beauahill/SmartHub/docs/diagrams/2_base_and_spine.png

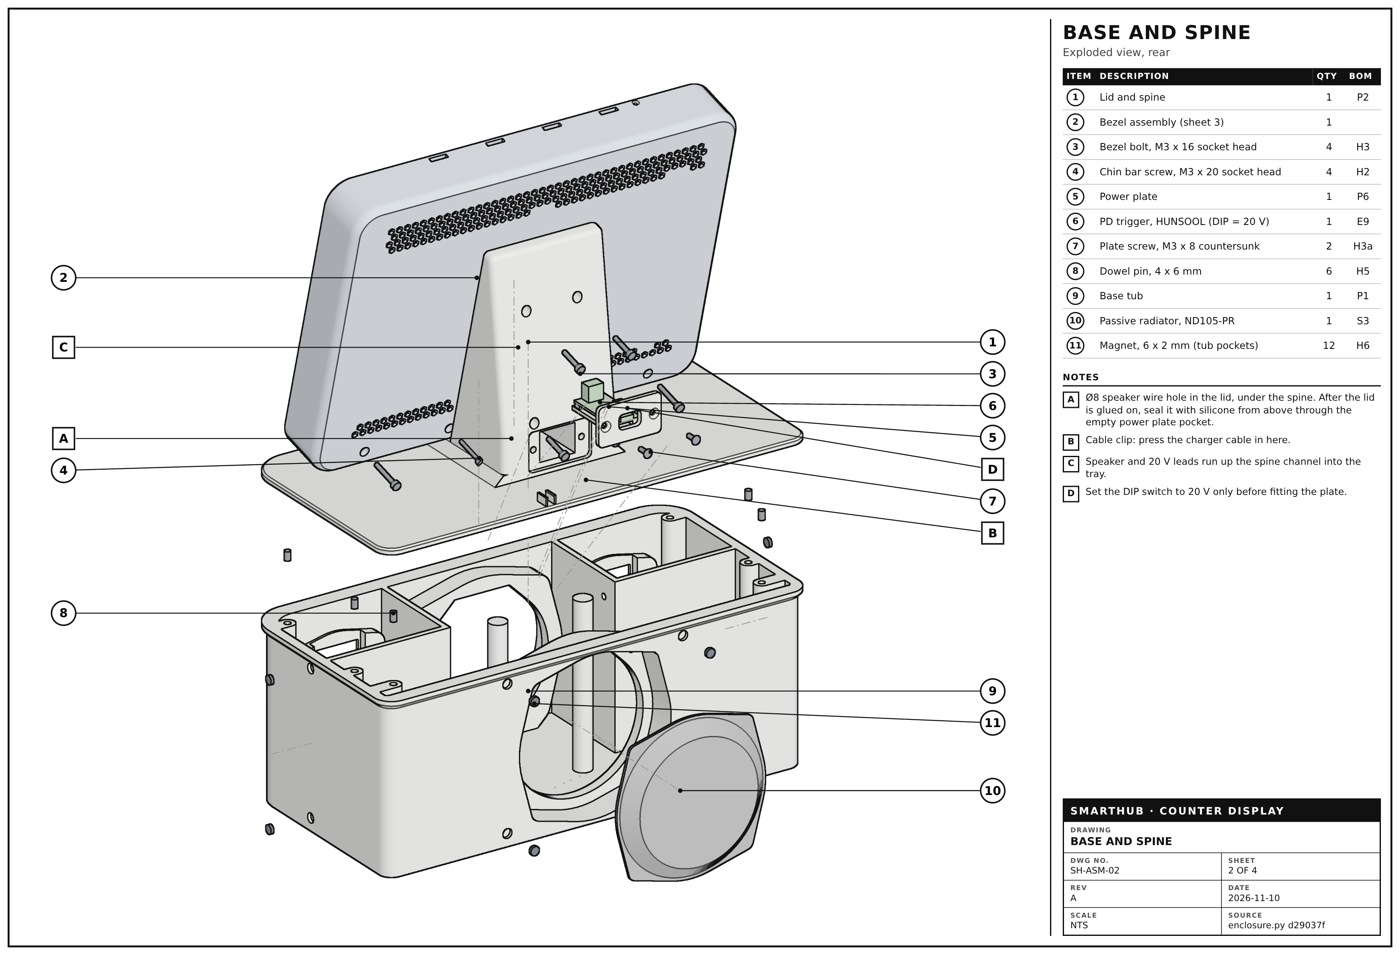
docs/diagrams/2_base_and_spine.png
