beauahill/SmartHub/enclosure/renders/current_corner.png

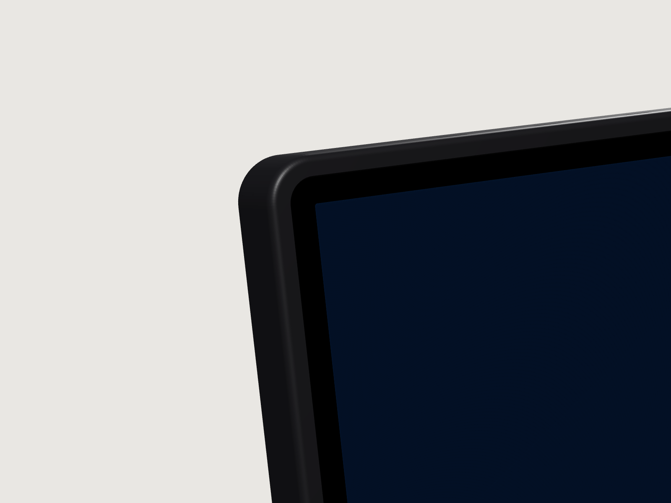
enclosure/renders/current_corner.png
