beauahill/SmartHub/enclosure/renders/rear.png

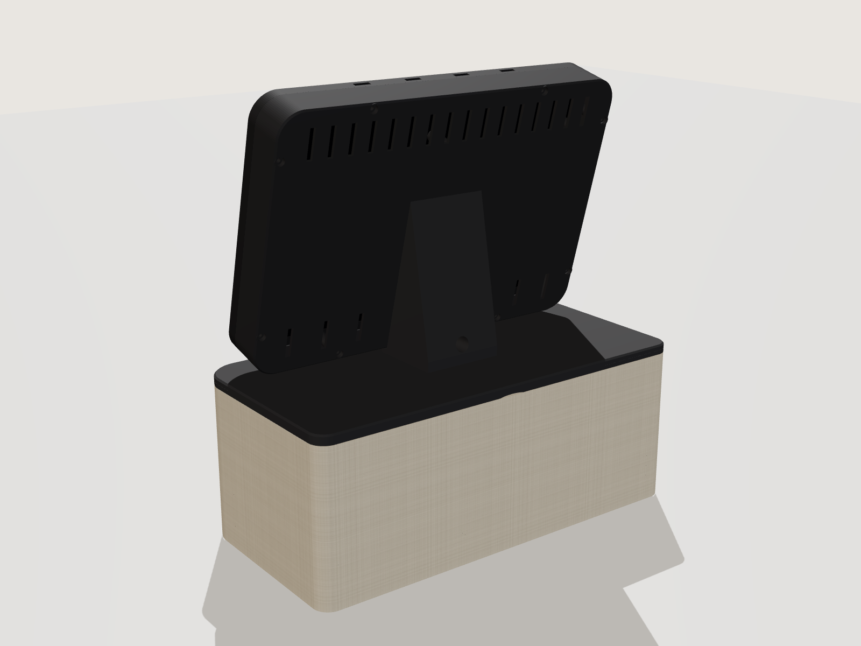
enclosure/renders/rear.png
