beauahill/SmartHub/enclosure/renders/side.png

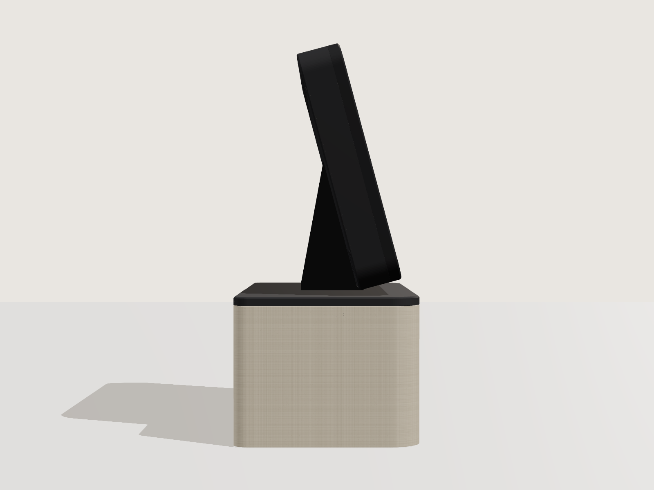
enclosure/renders/side.png
