beauahill/SmartHub/homeassistant/dashboards/wallpaper/counter_wallpaper.png

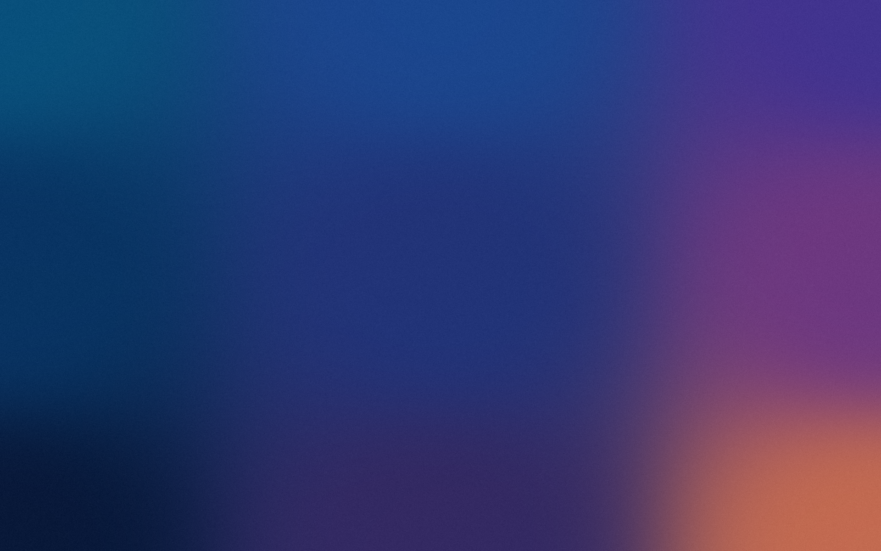
homeassistant/dashboards/wallpaper/counter_wallpaper.png
