beauahill/SmartHub/enclosure/stl/power_plate_adafruit_first_build.stl

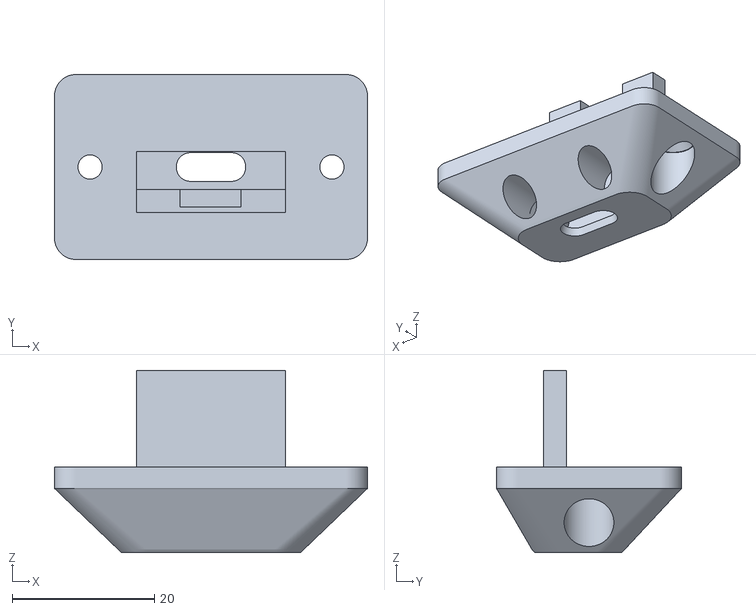
[picture p16: CAD file, 2026-11-10]
enclosure/stl/power_plate_adafruit_first_build.stl
44.0 x 26.0 x 25.6
