beauahill/SmartHub/enclosure/stl/base_tub.stl

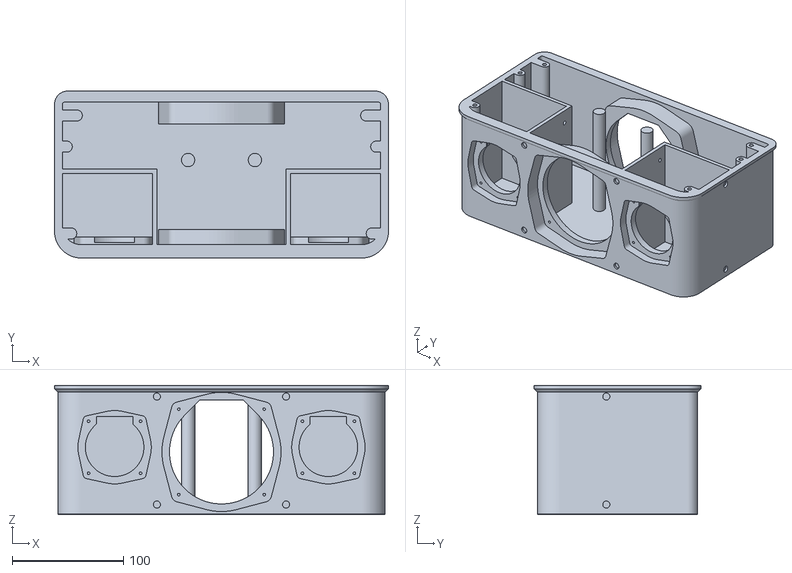
[picture p17: CAD file, 2026-11-10]
enclosure/stl/base_tub.stl
300.0 x 150.0 x 116.0
