beauahill/SmartHub/enclosure/stl/lid_spine.stl

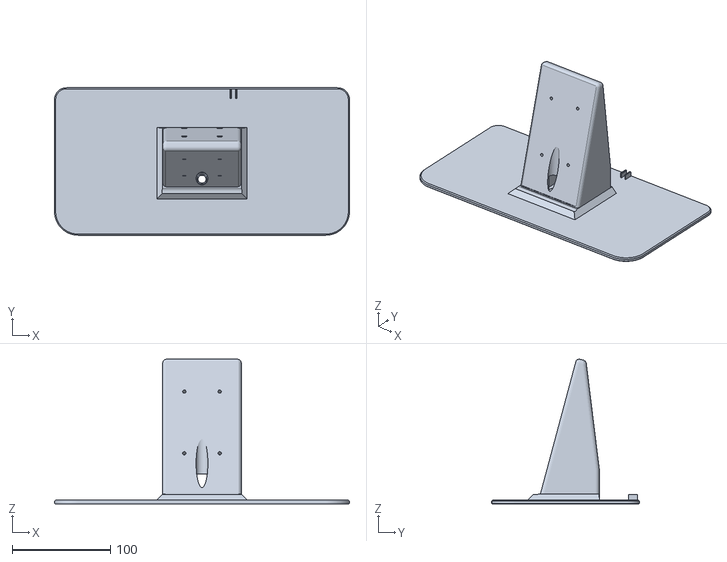
[picture p18: CAD file, 2026-11-10]
enclosure/stl/lid_spine.stl
300.0 x 150.0 x 147.2
