beauahill/SmartHub/enclosure/stl/bezel_shell.stl

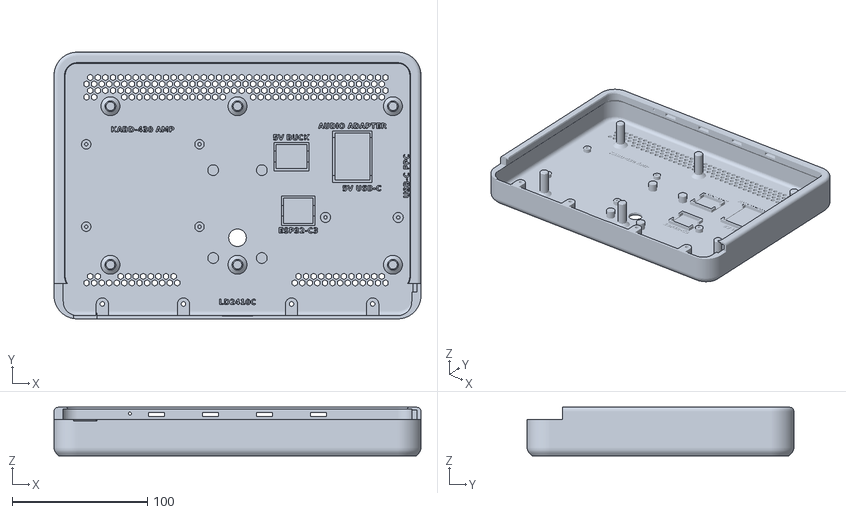
[picture p19: CAD file, 2026-11-10]
enclosure/stl/bezel_shell.stl
271.5 x 197.3 x 35.9
