beauahill/SmartHub/enclosure/stl/bezel_chin.stl

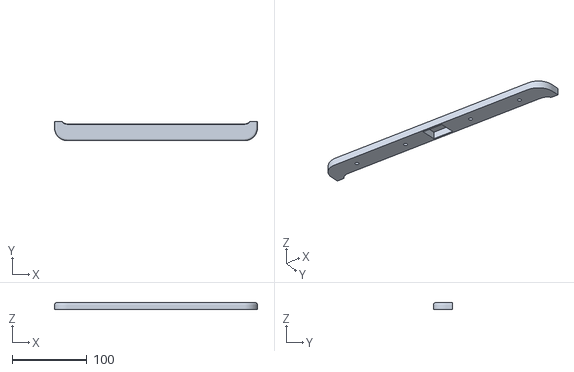
[picture p20: CAD file, 2026-11-05]
enclosure/stl/bezel_chin.stl
271.5 x 26.0 x 8.90
