beauahill/SmartHub/enclosure/stl/power_plate.stl

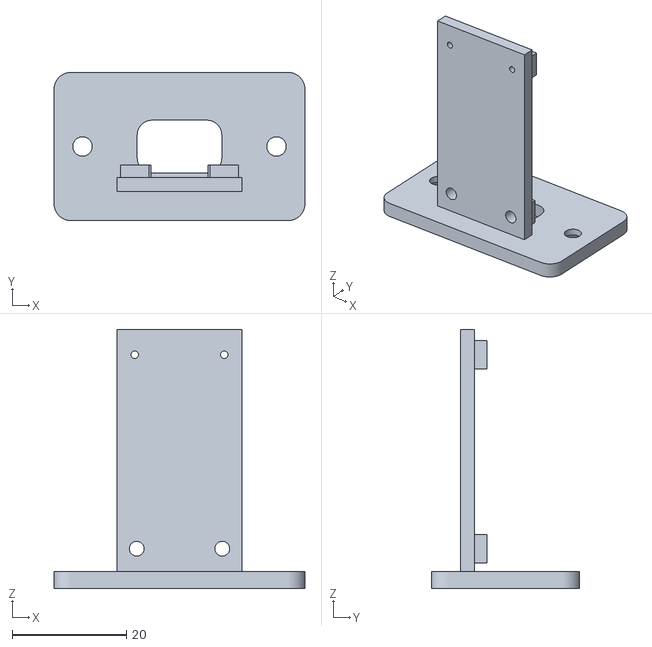
[picture p21: CAD file, 2026-11-04]
enclosure/stl/power_plate.stl
44.0 x 26.0 x 45.4
