beauahill/SmartHub/enclosure/stl/grille_shell.stl

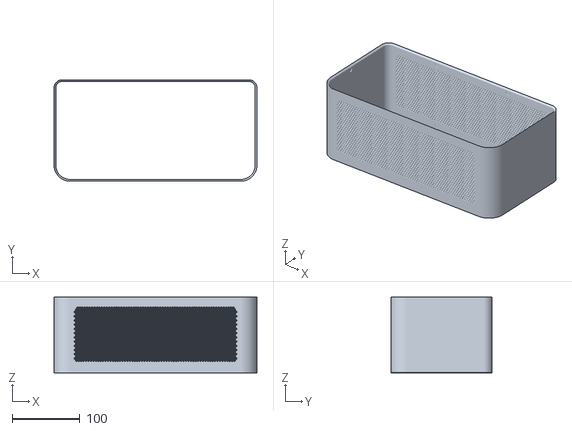
[picture p22: CAD file, 2026-10-29]
enclosure/stl/grille_shell.stl
300.0 x 150.0 x 111.6
