beauahill/SmartHub/enclosure/stl/grille_ring.stl

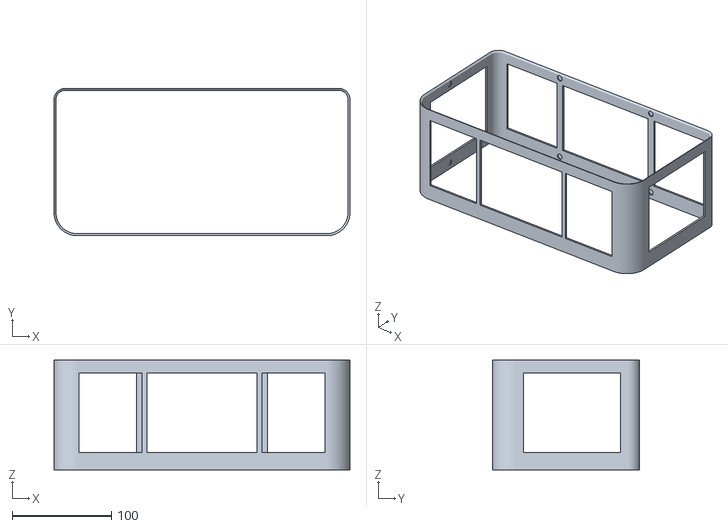
[picture p23: CAD file, 2026-10-29]
enclosure/stl/grille_ring.stl
298.8 x 148.8 x 110.8
