beauahill/SmartHub/docs/diagrams/1_general_assembly.png

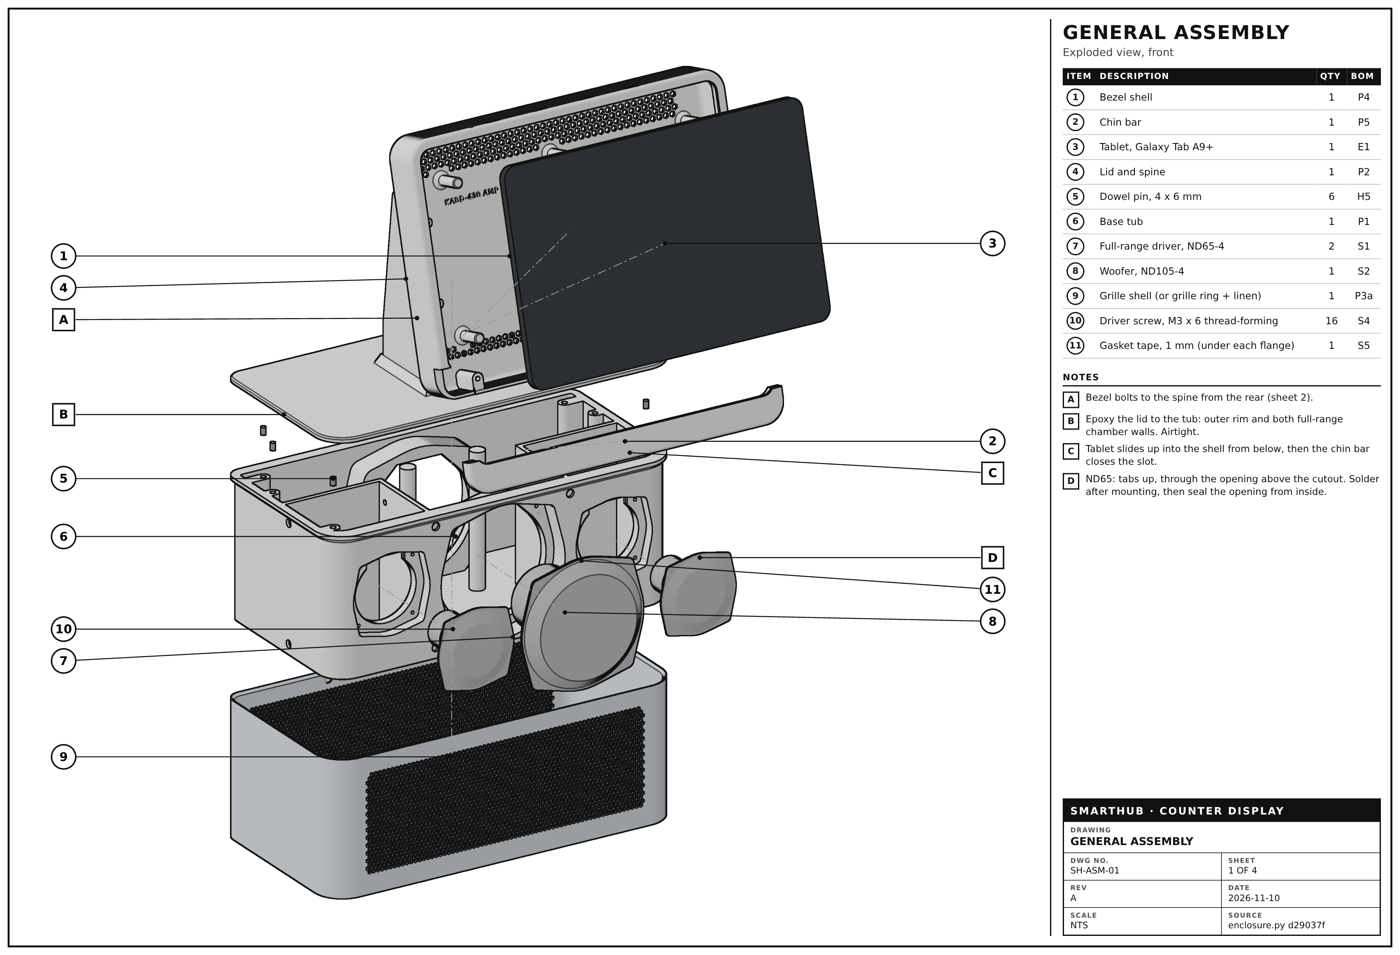
docs/diagrams/1_general_assembly.png
