beauahill/SmartHub/docs/diagrams/3_bezel_assembly.png

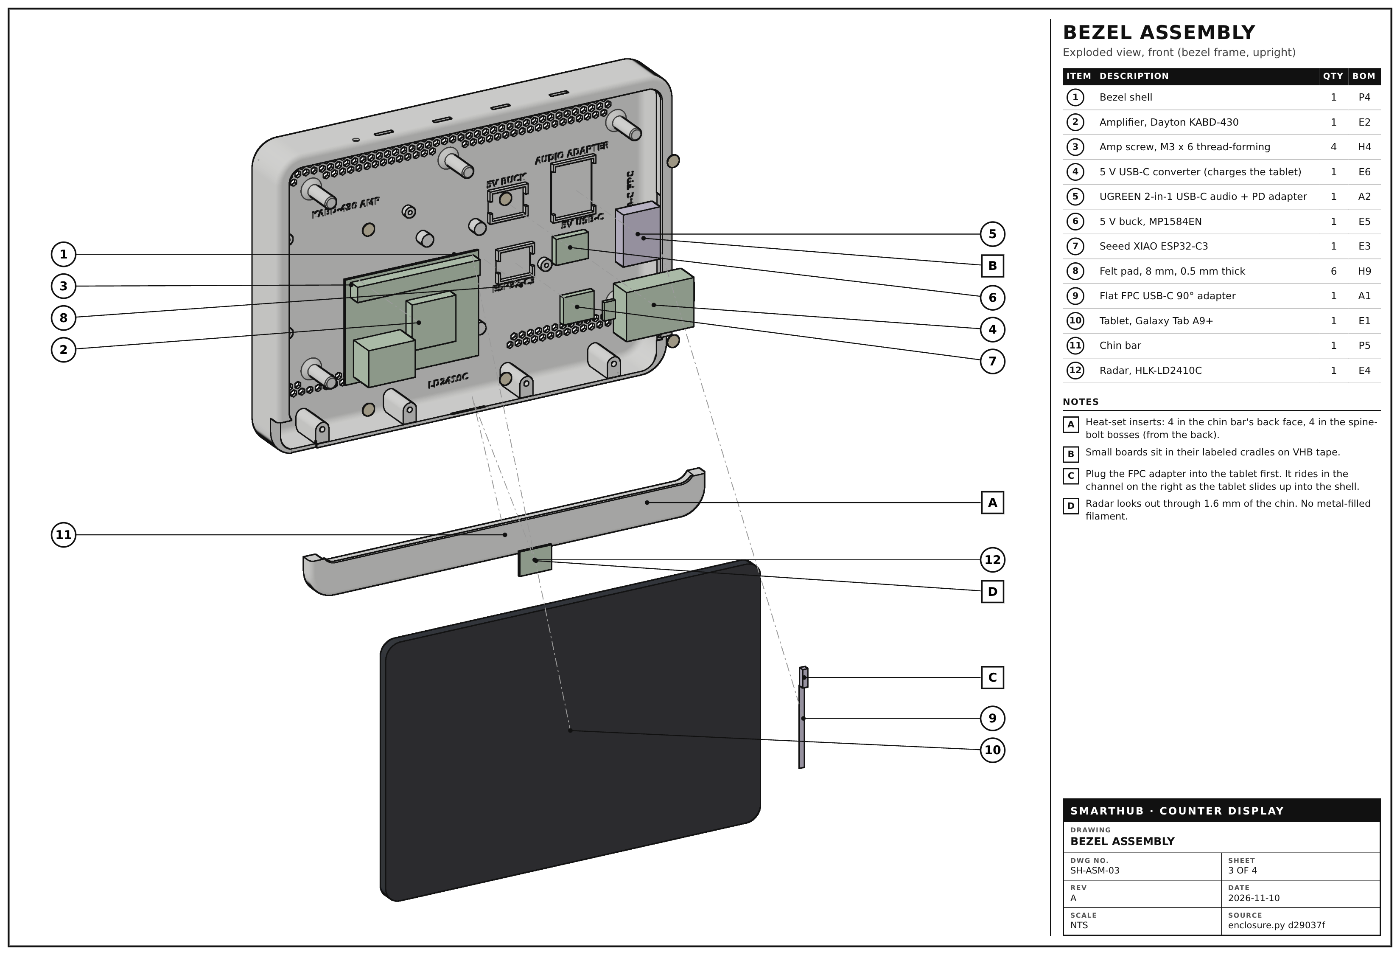
docs/diagrams/3_bezel_assembly.png
