beauahill/SmartHub/docs/diagrams/4_wiring.png

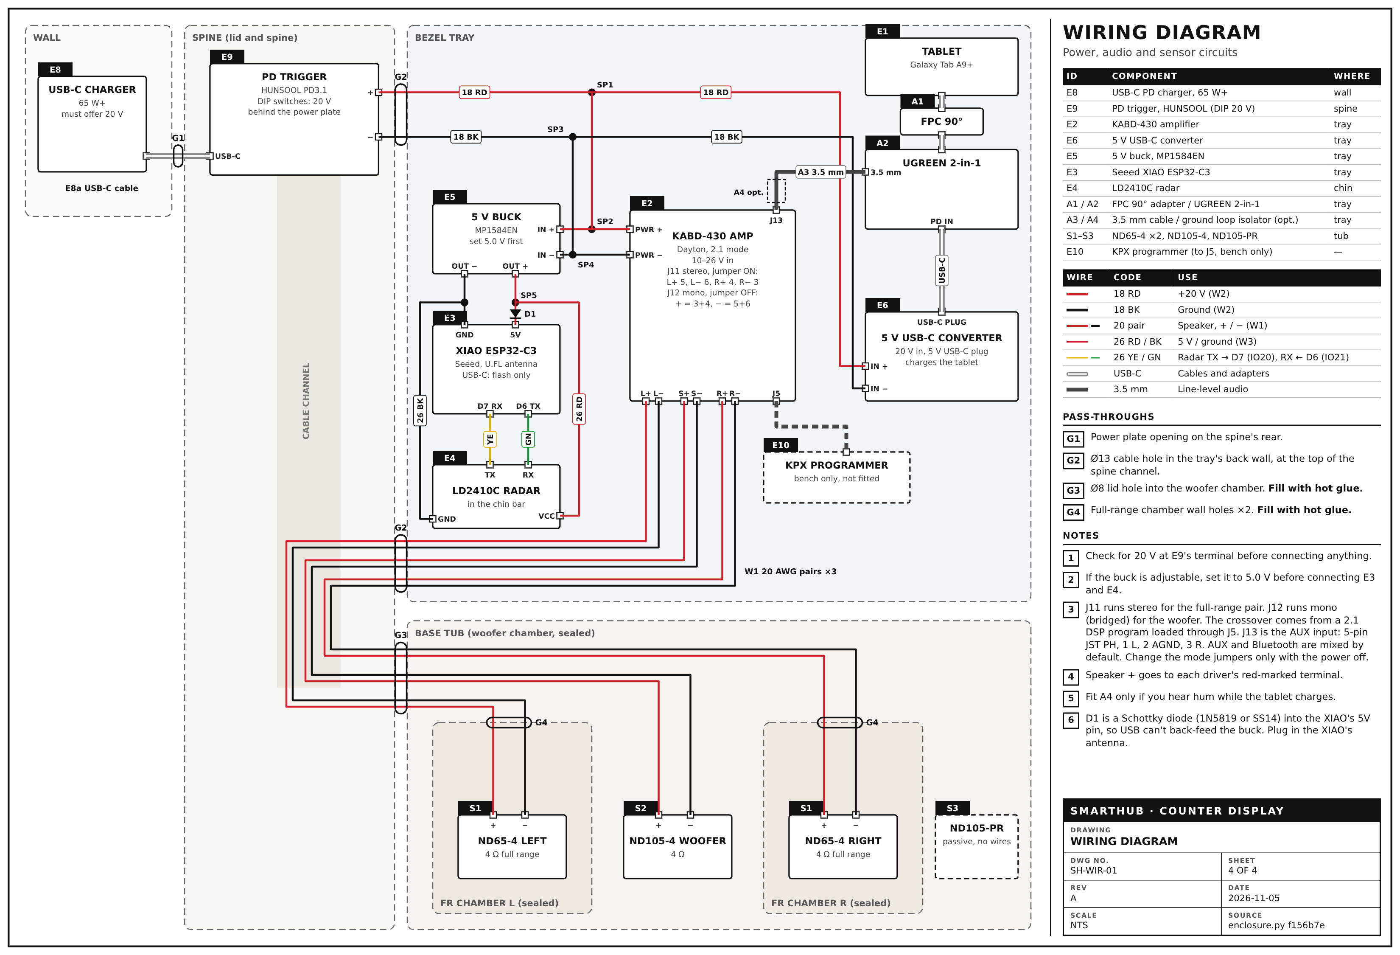
docs/diagrams/4_wiring.png
