beauahill/SmartHub/(commit log)

2026-10-28 Import Counter Display project from Cowork, add README and BOM
    Brings in the Counter Home Android launcher, the ESPHome presence sensor,
    the Home Assistant package and the parametric 3D-printed enclosure with its
    STLs and renders.
    Changes from the Cowork export:
    - Leave the release signing keystore out of this public repo; release builds
    sign only when android/keystore/counterhome.jks is present.
    - setup.sh now prints the three secrets the HA package actually reads
    (counter_display_api and counter_display_status, not counter_display_url).
    - Fix the enclosure.py docstring to match the exported part names and note
    the magnet sizes that fit the pockets.
    - Add a top-level README, BOM.md,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
    [base_tub.stl, bezel_front.stl, bezel_tray.stl, grille_ring.stl, lid_spine.stl]
2026-10-28 Fix design review items; document the 3.5 mm audio path
    Enclosure (STLs regenerated):
    - Magnet pockets now fit a 6x2 mm magnet in the tub and a 6x1 mm magnet
    flush in the grille ring.
    - Bezel side borders widened to 13 mm so a right-angle USB-C adapter has
    10 mm past the tablet edge (USB_CLEAR, FRAME_SIDE).
    - Cradles in the tray for the PD module, UGREEN 2-in-1 audio adapter,
    5 V buck and ESP32-C3.
    - Blind pilot holes for the driver screws on parametric bolt circles.
    - Rear brace columns overlap the side walls, removing the four
    non-manifold edges in base_tub.
    Counter Home 1.1.0:
    - Media volume cap (maxVolume, default 80 %), enforced on every volume
    change, settable in settings or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
    [base_tub.stl, bezel_front.stl, bezel_tray.stl, grille_ring.stl, lid_spine.stl]
2026-10-28 Swap the Wondom JAB4 for the Dayton Audio KABD-430
    - enclosure.py: amp parameters (AMP_HOLES 83.8 x 61.0, AMP_H, AMP_STANDOFF).
    Tray depth now follows the amp height: 30 mm for a 23 mm board. The
    tray screw counterbores deepen with it so M3 x 25 still works.
    - Regenerated bezel_tray and lid_spine STLs.
    - README and BOM: KABD-430 specs, J13 AUX input via the KABD functional
    cable kit, ICP1/KPX programmer, Bluetooth mixing note.
    Claude-Session: https://claude.ai/code/session_014zeCf1A9dQtoAZXhk6skwm
    [bezel_tray.stl, lid_spine.stl]
2026-10-28 Replace the 24 V pigtail with a flush panel-mount jack
    The spine's rear face is now flat and tall enough for a 40 x 24 mm jack
    plate. A DC-099 (5.5 x 2.1 mm, 11 mm hole) nuts onto the plate, which sits
    flush in a pocket and is held by two M3 countersunk screws in heat-set
    inserts. A 19 mm cavity behind the pocket clears the nut and opens into
    the cable channel. New printed part: dc_plate.stl.
    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
    [dc_plate.stl, lid_spine.stl]
2026-10-28 Driver mounts from Dayton's spec sheets and the ND65 3D model
    - Bolt circles corrected: 66 mm (ND65), 108.5 mm (ND105-4 and ND105-PR),
    replacing the 58 / 99 mm estimates.
    - Frame-shaped recesses (round body plus corner ears) replace the round
    counterbores, which neither frame fit.
    - The ND105 surround stands 10 mm proud of its mounting face, so the old
    4 mm counterbore left the woofer and passive radiator 3 to 4 mm through
    the fabric. Each driver now sits in a well deep enough for excursion
    clearance (4 / 5 / 9 mm) on a thickened mounting ring, with a 1 mm
    gasket allowance.
    - ND65 recess has a top-side notch for the solder tabs, checked against
    Dayton's STL: no interference bey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
    [base_tub.stl]
2026-10-28 Add raised component labels inside the bezel
    Tray back wall: PD MODULE, AUDIO ADAPTER, 5V BUCK and ESP32-C3 beside
    their cradles, KABD-430 AMP above the amp standoffs, and USB-C 90° by the
    USB notch. Back of the chin: LD2410C beside the radar pocket, mirrored so
    it reads from the tray side. Labels are 0.6 mm raised DejaVu Sans Bold,
    face up in both print orientations, and follow the cradle positions.
    matplotlib added to enclosure requirements for the font outlines.
    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
    [bezel_front.stl, bezel_tray.stl]
2026-10-28 Restyle the bezel with larger radii and rounded edges
    - Corner radius 28 mm (was 19), 4 mm front and 6 mm back round-overs
    (were 1.2 mm chamfers), 1 mm chamfer around the screen window. On the
    print-bed edge each round-over finishes as a 45 deg chamfer.
    - Tray inner shell follows the outer curve, keeping a 2.4 mm wall.
    - Top border 12 mm (was 9) with the chin unchanged at 21 mm. Screws move
    inward so their counterbores clear the rounded back edge; bosses grow
    to 9 mm; top vents and mic slots shift to stay clear.
    - The spine now hugs the curved tray back.
    - New current_* renders of the current design; README keeps the
    original Cowork renders for reference.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
    [bezel_front.stl, bezel_tray.stl, lid_spine.stl]
2026-10-28 Add a fabric-free grille shell as an alternative base finish
    - grille_shell: printed 2.85 mm skin that replaces the grille ring and
    linen. Flush with the tub's top band, honeycomb of pointy-top hexagon
    holes (2.6 mm across flats, 1 mm web, ~52 % open) over the front and
    rear, same magnet pockets and slide-on fit. Optional side perforation.
    - Driver clearance is now measured to the inner face of the ring or
    shell instead of the linen. The ring's rails already sat 2.25 mm closer
    than the fabric, so the seats move 2.25 mm deeper and the stated
    4 / 5 / 9 mm clearances hold for both finishes.
    - Renders of the shell version; README and BOM cover both finishes.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
    [base_tub.stl, grille_shell.stl]
2026-10-28 Switch power input to USB-C PD with a redesigned rear plate
    - power_plate replaces dc_plate: a 44 x 26 mm flush plate with a 14.4 x
    8.8 mm chamfered opening that the plug overmold passes through, and a
    sled on its back for an Adafruit HUSB238 PD trigger (product 5991) set
    to 20 V. Board outline, mounting holes and socket position come from
    Adafruit's published PCB files; pads under the holes and reliefs under
    the socket shell and terminal pins.
    - Spine: rectangular cavity for the board and screw terminal, opening into
    the cable channel; plate screws moved to +-17 mm.
    - Fit checked with a board and plug model: no interference with the plate,
    spine or tray; a 13 x 7 mm overmold s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
    [dc_plate.stl, lid_spine.stl, power_plate.stl]
2026-10-29 Counter Home 1.2.0: tablet camera as a Home Assistant security camera
    - CameraStreamer (Camera2, no libraries): YUV frames at a set rate,
    compressed to JPEG, rotated upright for the screen orientation.
    - API: POST /camera/on?minutes=N, POST /camera/off, GET /camera.jpg,
    GET /camera.mjpeg (up to 3 streams), camera state in /status, camera
    settings in /config.
    - Privacy: off by default; "Allow the camera" can only be changed in the
    on-device settings behind the PIN, not over the API. Snapshot and stream
    requests never switch the camera on. Red CAM indicator in the dock.
    - Android 14: the service claims the camera foreground-service type while
    the launcher is on screen (onCreate and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
2026-10-29 Frameless bezel: one-piece shell with a thin rim, plus a chin cap
    - The tablet's own glass border now shows. A 6.8 mm rim wraps the tablet
    with a 1.2 mm lip overlapping the glass by 1.5 mm; the corner radius
    follows the rim. Front camera and light sensor are uncovered.
    - bezel_front + bezel_tray become bezel_shell (rim, pocket and tray in one
    piece, no front seam) and bezel_chin (radar, closes the bottom).
    - The tablet slides up into the shell from below; the pocket is square
    below the tablet's center so its corners pass. The chin screws on from
    underneath (3 x M3 x 12 into inserts in bosses).
    - The bezel now bolts to the spine from the spine's rear (4 x M3 x 16 into
    inserts in t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
    [bezel_chin.stl, bezel_front.stl, bezel_shell.stl, bezel_tray.stl, lid_spine.stl]
2026-10-29 Bezel: print without supports
    - The 255 mm lip strip along the bottom of the glass was held only at its
    ends. It now belongs to the chin, which supports it along its length.
    - The chin is now a solid front bar (radar pocket + bottom lip strip),
    screwed in from the back of the tray with 4 x M3 x 20 into inserts. The
    lower tray stays with the shell. The bar prints back face down with no
    overhangs; the old U-shaped chin needed supports in every orientation.
    - The tray's inside tapers at 45 deg where it meets the wider rim, instead
    of a flat 4.4 mm ledge.
    - USB-C channel ceiling moved 0.8 mm back (more material above it).
    - Overhang check in print orientation: only 12 mm mic-slot bridg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
    [bezel_chin.stl, bezel_shell.stl]
2026-10-29 Seal the woofer chamber: 6 mm lid wire hole, glued shut
    The 12 mm hole in the lid at WIRE_HOLE opened the woofer chamber to the
    bezel tray through the spine's cable channel, so the passive-radiator box
    was ported. The channel's lower sphere also cut through the 4 mm lid on
    its own, so shrinking the hole alone would not have closed it.
    - Lid hole is now WIRE_HOLE_D = 6 mm, enough for three 20 AWG pairs.
    - The channel's low end dips only 1 mm into the lid, leaving the lid
    closed around the hole.
    - The script prints the open area through the lid, since the chamber
    volume printout assumes a closed box.
    - README assembly step 3 feeds the speaker pairs through the lid and
    hot-glues the hole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
    [lid_spine.stl]
2026-10-29 Tub: print without interior supports
    - 45 deg chamfer under the top band instead of a 3 mm flat ledge; ring and
    shell tops beveled to match, both now print bottom edge down
    - Mounting rings taper at 45 deg below; driver cutouts get 45 deg sides and a
    flat bridged top
    - Woofer and radiator centers lowered to Z 56.25 so their recesses stay under
    the band chamfer
    - ND65 tab notch: floor moved below the cutout (removes a knife-edge sliver),
    starts 1.2 mm behind the seat so the solder tabs clear with the gasket fitted
    - 0.6 mm chamfer on the bottom outer edge for elephant's foot
    - Grille ring / shell clearance 0.15 -> 0.35 mm
    - README: tub print settings for PLA+ on an H2S; BOM volumes up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
    [base_tub.stl, grille_ring.stl, grille_shell.stl]
2026-10-29 Grille shell print review; lid wire hole 8 mm
    - Shell and ring: 0.5 mm lead-in chamfer on the inner bottom edge (slide-on
    guide, room for elephant's foot inside the 0.35 mm clearance); 0.3 mm
    chamfer on the shell's outer bottom edge
    - Print STLs for the ring and shell now sit on z = 0
    - Lid wire hole 6 -> 8 mm, bored straight up into the channel: three 20 AWG
    zip-cord pairs (about 2 x 4 mm each) don't fit through 6 mm
    - README: grille shell print settings
    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
    [grille_ring.stl, grille_shell.stl, lid_spine.stl]
2026-10-29 Tub: web the lid dowel columns to the side walls
    Four of the six columns stood free; the front pair left a ~0.6 mm slot
    against the curved corner wall. Each column is now hulled out to the side
    wall, so it braces the wall and prints as part of it. Chamber air drops
    0.8 % (woofer, 2.654 L) and 0.6 % (full range, 0.538 L).
    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
    [base_tub.stl]
2026-10-29 Lid spine print review
    - Spine top ends in a 5 mm flat instead of a 60 mm wide knife edge
    - 0.2 mm gap between the spine and the tray back, so the tray's curved
    bottom edge can't hold the faces apart (bolt engagement unchanged)
    - Lid dowel holes 2 -> 2.8 mm deep: with the tub's 4 mm holes and 6 mm
    dowels there was no slack, so a short hole would hold the lid off the tub
    - 0.4 mm chamfer on the lid's bottom outer edge (elephant's foot at the joint)
    - Straight 12 mm throat above the lid wire hole: removes a thin lip where the
    trigger cavity floor met the channel's low sphere
    - Lid open-area check samples above the deeper dowel holes
    - README: lid/spine print settings; epoxy the full-rang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
    [lid_spine.stl]
2026-10-29 Bezel shell print review
    - Bezel shell and chin print STLs now sit on z = 0 (were below the plate)
    - README: corrected the USB-C channel roof (5.5 mm one-sided overhang, can't
    be sloped without hitting the plug) with a painted-support fallback; added
    the chin radar window bridge; bezel shell print settings for the H2S
    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
    [bezel_chin.stl, bezel_shell.stl]
2026-10-29 Lid: power cable clip behind the spine
    Two 1.2 mm posts with 45 deg hooks on the lid top (Y 132-142), sized by
    CABLE_D (4.5 mm). The charger cable drops from the USB-C plug onto the lid
    and runs back through the clip to the rear edge.
    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
    [lid_spine.stl]
2026-10-30 Assembly and wiring diagrams
    Four service-manual style sheets in docs/diagrams (PNG plus a printable PDF):
    general assembly, base and spine (rear), bezel assembly, and a wiring
    diagram with zones, wire codes, splices and sealed pass-throughs. Each sheet
    has numbered balloons keyed to the BOM and a title block.
    docs/diagrams/tools regenerates them from enclosure.py: parts.py builds the
    meshes and manifest, render.html draws the exploded line-art views,
    wiring.html the schematic.
    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
2026-11-02 README: how to cover the grille ring with linen
    The ring clears the tub by 0.35 mm inside and the band chamfer by about the
    same at the top, so 0.6 mm linen can't wrap over either edge: it goes on the
    outer face only, trimmed flush, with a butt seam at the rear right corner.
    BOM M2 resized (900 x 130 mm) and M3 notes updated.
    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
2026-11-03 README: PETG print settings for the bezel shell and chin bar
    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
2026-11-03 Tub: ND65 solder tabs pass through the mounting face
    The tab notch started 1.2 mm behind the mounting face, so the square-cornered
    tabs (0.7 mm outside the 52.6 mm cutout) hit that skin on the way in and the
    ND65s couldn't be fitted, though they cleared once seated.
    - Opening through the face: 32.8 mm wide, 27.8 mm from the axis, 45 deg top
    corners, still under the flange
    - Behind a 2 mm skin the relief opens through the top of the mounting ring
    (no thin ceiling)
    - Checked by sliding Dayton's ND65 model along the insertion path: no contact
    with or without the gasket; seated clearance unchanged at 0.21 mm
    - README step 4: mount the ND65s unwired, solder from the open chamber top,
    sea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
    [base_tub.stl]
2026-11-04 Bezel: clear the tablet's camera bump; stronger back-stop posts
    The rear camera bump (top-left in landscape, seen from the front) sweeps a
    lane up the left side as the tablet slides in, right through the left posts
    at x = -115, and snapped them off on the test print.
    - Camera parameters (CAM_FROM_LEFT, CAM_D, CAM_H, estimated) set a lane the
    posts must stay out of; left pair moved to x = -94 (asserted)
    - Posts: 3 mm 45 deg fillet at the back wall, 0.8 mm tip chamfer
    - Relief groove in the entry slot, where the bump caught the front edge of
    the tray's bottom wall
    - Slide-in check with a tablet + bump model: no contact
    - README: in PETG the 1.9 mm lip overhang needs painted tree supports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
    [bezel_shell.stl]
2026-11-04 Bezel: side-key pin holes, measured audio cradle; PETG-only supports
    - 2.2 mm countersunk pin holes through the top rim onto the power and
    volume-down keys (KEY_FROM_LEFT, estimated); skipped when a key sits under a
    mic slot, asserted clear of the slots otherwise
    - UGREEN cradle resized to the measured 34 x 25.3 x 9.8 mm body, ports facing
    -x, both long faces open (cradles take an optional exit-gap width)
    - README: paint PETG tree supports with a 0.25-0.3 mm top gap; a PLA
    interface costs a filament swap per layer on a single-nozzle H2S
    - BOM: E6 is the 12/24 V to 5 V USB-C converter (5 V, no PD); A2 measured
    Claude-Session: ht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
    [bezel_shell.stl]
2026-11-04 Measured camera, HUNSOOL trigger and 5 V converter
    - Camera bump: 16 mm from the left and top edges, 13.3 mm, 1.5 mm proud.
    Posts and the entry-slot groove follow; slide-in check clear
    - PD trigger: HUNSOOL PD3.1 (40.3 x 20.5 mm, socket on top of the board,
    measured holes). The spine depth now follows the board (REAR_Y from the
    cavity, 6 mm wire room and a 3 mm wall to the bezel face): 11 mm deeper.
    Cable clip moved back to Y 139 (asserted clear of the plug)
    - 5 V USB-C converter (charges the tablet) on two 4 mm bosses at its ear
    holes, replacing the 40 x 25 placeholder cradle
    - README, BOM, wiring diagram and assembly sheets updated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
    [bezel_shell.stl, lid_spine.stl, power_plate.stl]
2026-11-04 Power-key pin hole at 49 mm; trigger pilots sized per hole
    - KEY_FROM_LEFT: power key measured at 49 mm from the left edge; the
    volume-down hole is dropped
    - TRIG_HOLES carry their own pilot: 2.6 mm for M3 thread-forming in the
    3.6 mm front holes, 1.3 mm for M1.7 self-tapping in the 1.8 mm rear holes
    - README step 7 and BOM E9a updated
    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
    [bezel_shell.stl, power_plate.stl]
2026-11-05 Presence sensor: Seeed XIAO ESP32-C3 instead of the SuperMini
    - ESPHome board seeed_xiao_esp32c3 (validated on 2026.10.1); radar stays on
    GPIO20/21, which are the XIAO's D7/RX and D6/TX
    - Wiring notes: 5 V into the XIAO's 5V pin through a Schottky diode (Seeed's
    guidance for an external 5 V feed), and plug in its U.FL antenna
    - Tray cradle resized to 21 x 17.8 mm
    - README, BOM, wiring diagram (D1 added) and assembly sheets updated
    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
    [bezel_shell.stl]
2026-11-05 BOM: USB-C coupler; README: log the fragile bezel lip-corner tabs
    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
2026-11-05 Bezel: lip corners move to the chin as solid blocks (future builds)
    The two lip tabs at the bottom corners of the window were 1.2 mm thick, held
    on two sides over the gaps the tablet's corners slide through, and broke
    easily on the first PETG build.
    - The chin now runs up to CHIN_SPLIT (26 mm, where the corner blocks are
    still 1.5 mm thick at the pocket wall) and carries solid blocks that fill
    the pocket corners outside the tablet's rounded corners, with the lip's
    corners on their front
    - Checked: the bar slides straight back past the seated tablet without
    contact; parts single and watertight; the shell's worst lip-corner overhang
    drops from 6.3 to 3.1 mm
    - README: review table en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
    [bezel_chin.stl, bezel_shell.stl]
2026-11-05 Docs: KABD-430 output wiring for 2.1
    From Dayton's quick-start wiring guide: J11 and J12 are 6-pin (1 GND,
    2 MODE, 3 OUTR-, 4 OUTR+, 5 OUTL+, 6 OUTL-); a MODE-GND jumper selects
    stereo, open selects mono (bridged), where pins 3+4 are MONO+ and 5+6 MONO-.
    - README step 9: J11 stereo for the ND65s, J12 mono for the ND105 (pairs
    joined at the plug so six conductors go down the spine), power on the
    centre connector, 2.1 DSP program through J5
    - BOM W4: the included harnesses; wiring diagram note 3 and amp pin table
    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
2026-11-05 Docs: KABD-430 AUX input (J13), pairing button and status LED
    From Dayton's KABD-430 manual: J13 is a 5-pin JST PH 2.0 mm header (1 Left
    in, 2 AGND, 3 Right in, 4-5 NC); J1 external BT LED (1 LED-, 2 LED+); J2
    pairing button (momentary); J10 standby. Bluetooth and AUX are mixed in the
    DSP by default; Bluetooth holds one device at a time.
    - README step 9: DIY AUX lead (tip 1, sleeve 2, ring 3), pairing button and
    LED notes; BOM A3; wiring diagram note 3
    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
2026-11-05 Lid: move the cable clip out of the power plate's path
    The HUNSOOL sled is 45 mm long, so the plate has to slide in straight for
    its last 45 mm, and its bottom edge (3 mm above the lid) hit the clip posts
    on the centre line 30-39 mm behind the spine. The fit check only placed the
    plate where it ends up.
    - CLIP_X = 32 mm, asserted clear of the plate's width
    - New build-time check: the plate's whole insertion path (sled length + 6 mm)
    must clear the lid and spine; it fails with the clip back on the centre line
    - README note on the clip position
    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
    [lid_spine.stl]
2026-11-05 Spine: route the speaker wires in front of the PD trigger, not under it
    The lid's wire hole and the bottom of the cable channel sat directly under
    the trigger board's sled, which (with the board and terminal) fills the
    cavity: 1.5 mm under the sled and at each side. The wires had no way past.
    This was true with the Adafruit board too; the HUNSOOL board made it worse.
    - WIRE_HOLE moves forward to Y 57, in front of the cavity; the channel now
    runs straight up from the lid to the tray past the board's end, where the
    trigger's terminal feeds it too. Throat 10 mm.
    - New build-time check: a 7 mm wire bundle along the hole and channel must
    not touch the spine, the power plate or the trigger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
    [lid_spine.stl]
2026-11-05 Add the first-build Adafruit power plate STL and the spine rework
    power_plate_adafruit_first_build.stl is the plate from 565ad77, for a lid and
    spine printed before the HUNSOOL change (55 mm deep at the lid). README
    documents the rework for that spine: a new 8 mm wire hole 62 mm from the
    lid's front edge, in front of the trigger board, and sealing the old one.
    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
    [power_plate_adafruit_first_build.stl]
2026-11-05 Bezel: tie the chin-screw bosses into the tray floor (future builds)
    The four bosses were 9 mm columns off the back wall only, with about 4 mm of
    air above the tray floor. Each now sits on a solid pedestal down into the
    floor. Checked: parts single and watertight, no new overhangs, tablet and
    camera-bump slide-in paths clear.
    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
    [bezel_chin.stl, bezel_shell.stl]
2026-11-09 Tablet provisioning: debloat, local HTTPS, pause fix, volume control (1.3.0)
    - debloat.sh / restore.sh with debloat-packages.txt: remove Samsung, Google,
    carrier and partner preloads per user; keep Play services, Play Store,
    WebView, Chrome, One UI Home, Samsung Keyboard and Device care. setup.sh
    runs it, and documents wireless debugging since the tablet's USB-C port
    feeds the audio adapter.
    - haCertName setting: load an HTTPS Home Assistant by LAN IP when its
    certificate names a public host the LAN can't reach (no NAT loopback).
    Accepted only for the dashboard host, the named cert, and no other errors.
    - Pause kiosk now empties the lock-task allowlist. stopLockTask() alone was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
2026-11-09 First-build power plate: snout for the Adafruit HUSB238 (5807)
    The old plate for the 55 mm spine assumed a socket on the PCB's centre
    line. On the 5807 it sits on top of the board, 2.4 mm higher, so the
    plug's overmold hit the opening. Its sled also covered the lid's wire
    hole and throat, so the hole couldn't be sealed.
    New plate, built by power_plate_first_build.py from Adafruit's CAD
    model: a tapered snout 9 mm out of the rear face holds the socket just
    behind its face. The board screws to the snout's floor (two M2.5 x 6)
    and rides on a tongue that ends 2 mm behind the wire throat, so the
    original hole is clear and can be glued shut. Same pocket, inserts and
    M3 screws. Prints snout down w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
    [power_plate_adafruit_first_build.stl]
2026-11-09 Home Assistant: kiosk dashboard, calendar setup and home-game sync
    dashboards/counter.yaml is the five-view dashboard the tablet shows
    (Home, Hot Tub, Lights, Security, Calendar), with the replaced one kept
    in dashboards/previous/. scripts/ pushes the dashboard and reloads the
    tablet, creates the Gillette community calendars, and syncs the
    Pronghorn and Gillette Wild home-game calendars. calendars/ holds the
    Gillette Wild home dates, which have no feed. Scripts read the HA token
    from HA_TOKEN or the git-ignored android/keystore/ha-secrets.yaml.
    README documents the dashboard, scripts and calendar setup.
    [counter.yaml]
2026-11-09 Counter dashboard: mesh-gradient wallpaper, clock card fix, Google Calendar steps
    - make_wallpaper.py renders a dark teal/indigo mesh gradient (1920x1200);
    set_wallpaper.py uploads it to HA's image store and sets it as every
    view's background. Old uploads are removed over the websocket.
    - clock-weather-card rewritten for the card's current header/segments
    format: "h:mm" time pattern so AM/PM no longer clips, NWS hourly strip
    and 5-day list, Venstar outdoor probe as the current temperature.
    - README: wallpaper workflow, kiosk-mode note, and the Google Cloud OAuth
    steps the Google Calendar integration needs (HA Cloud linking isn't
    offered for it).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
    [counter.yaml]
2026-11-09 Counter Home 1.4.0: hands-free voice, sleep screen, Radio tile
    Voice: the tablet is an Assist satellite. While the screen is on, Voice.kt
    streams the microphone over Home Assistant's websocket into the Assist
    pipeline (wake-word stage, one-hour runs), plays the spoken answer, and
    shows a caption of what was heard and the reply; a green MIC dot marks an
    open microphone. setup_voice.py prepares Home Assistant: openWakeWord
    add-on, Wyoming entry, "okay_nabu" on the preferred pipeline, Radio and
    Counter dashboard scripts, spoken aliases for the gate, garage doors,
    locks and the outdoor sensors. Empty wake-word results (service restart)
    are not treated as detections and short-lived runs back off.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
2026-11-09 Glass dashboard and dock: one screen per view, Counter Home 1.5.0
    Dashboard (counter.yaml): rebuilt in the style of Apple Home. Every view
    fits the 11" screen with no scrolling: the view title and a navigation
    pill on top, then three columns of dark glass tiles over the wallpaper.
    A tile turns white while its light is on, its door is open or its lock
    is unlocked; tap acts, hold opens the details. The tiles are button-card
    (v7) templates kept at the top of the file. The look does not depend on
    card-mod or on a Home Assistant theme: the title template writes the
    glass variables onto the sections view for the few core cards (weather,
    thermostat, calendar, camera). mushroom and clock-weather-car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
2026-11-09 Voice: Claude as the Assist conversation agent
    setup_voice.py --conversation-agent <conversation.*> points the preferred
    pipeline at a conversation entity (the Anthropic integration's Claude
    agent) with prefer_local_intents on, so built-in sentences still handle
    device commands instantly and Claude takes the rest. README explains the
    Anthropic integration setup and the split.
2026-11-10 Future build: rounded, stiffer spine; tub braces; honeycomb vents; seal from above
    - Spine 80 mm wide (was 60) and 145 mm up the tray back (was 115); outer
    edges rounded with a Minkowski sum (SPINE_R 4), sides and front flared 45 deg
    into the lid; top land 10 mm
    - Bezel bolts at 45 and 110 mm (65 mm apart vertically, was 35): upper pair in
    12 mm counterbores; lower pair unchanged
    - Two 12 mm brace columns in the tub under the spine's sides, glued to the
    lid (SPINE_BRACES), clear of the woofer motor and radiator by > 2 mm;
    woofer chamber 2.629 L
    - Back-wall vents: two honeycomb bands of 4 mm hexagons, kept clear of the
    back-stop posts (the old slots cut into two of them)
    - Funnel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
    [base_tub.stl, bezel_shell.stl, lid_spine.stl]
2026-11-10 README: note the tablet-assembly issue and the front-frame option (on hold)
    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
